evortriede/CurrentMonitor/hardware/CurrentMonitorBOM.md

# Current Monitor Bill of Materials

- Obtained specifically for this project
  - Heltec ESP32 LoRa V2 microcontroller [ESP32](https://smile.amazon.com/gp/product/B07HJ49VN8)
  - High Gain Antenna [Antenna](https://smile.amazon.com/gp/product/B091PRHPTJ)
  - Current Sensor [Sensor](https://smile.amazon.com/gp/product/B00J2N3GSY)
- Various materials on-hand at shop
  - Strip board (cut down to size) [Strip Board](https://smile.amazon.com/gp/product/B088GSJM7G)
  - Wire
  - Resistors
  - Solder
  - Dupont Connector Kit [Dupont kit](https://smile.amazon.com/gp/product/B07JG8HVLG)
    - Dupont Connectors
    - Sockets
    - Headers
