evortriede/CurrentMonitor/(list of files, drawings)

Other design files:
hardware/Current Monitor V4.dsn
