evortriede/CurrentMonitor/ModBussLoop.ino

bool getConnection()
{
  if (!client.connected())
  {
    if (millis()>=timeToConnect)
    {
      Serial.print("connecting to ");
      Serial.println(configData.modbusServer);
      if (client.connect(configData.modbusServer,502))
      {
        timeToSendVolume=millis();
        timeToSendTurbidity=millis()+30000L;
        Serial.println("connected");
      }
      else
      {
        Serial.println("couldn't connect");
        timeToConnect=millis()+60000;
        return false;
      }
      transId=1;
      volTid=0;
      turbTid=0;
    }
  }
  return true;
}

bool getNewConnection()
{
  client.stop();
  return getConnection();
}

uint16_t getUInt16(byte *msg)
{
  uint16_t retVal=msg[0];
  retVal<<=8;
  retVal+=msg[1];
  return retVal;
}

void sendReadHoldingRegister(uint16_t registerNo, uint16_t transactionId)
{
  byte message[12];
  message[0]=transactionId>>8;
  message[1]=transactionId&0xff;
  message[2]=0; // protocol id
  message[3]=0; // protocol id
  message[4]=0; // length msb
  message[5]=6; // length lsb
  message[6]=0; // unit id
  message[7]=3; // function code (read holding registers)
  message[8]=registerNo>>8;
  message[9]=registerNo&0xff;
  message[10]=0; // how many msb
  message[11]=1; // how many lsb
  client.write(message,12);
}

void modbusWriteRegisters(uint16_t startingRegNo, uint16_t *rgVal, byte nVal)
{
  if (!wifiStaConnected) return;

  if (!getConnection()) return;

  byte message[22];
  uint16_t *ps;
  message[0]=transId>>8;
  message[1]=transId&0xff;
  transId+=1;
  if (transId==0) transId=1;
  message[2]=0; // protocol id
  message[3]=0; // protocol id
  message[4]=0; // length lsb
  message[5]=7+(2*nVal); // length msb
  message[6]=0; // unit id
  message[7]=16; // function code (write holding registers)
  message[8]=startingRegNo>>8;
  message[9]=startingRegNo&0xff;
  message[10]=0;
  message[11]=nVal;
  message[12]=nVal*2;
  ps=(uint16_t*)(void*)&message[13];
  for (int j=0;j<nVal;j++)
  {
    *ps++=*rgVal++;
  }
  client.write(message, 13+(2*nVal));
}

bool pollResponse(uint16_t &transactionId, uint16_t &respValue, uint16_t &swapRet)
{
  byte message[12];
  if (client.available()<10) return false;
  Serial.printf("available=%i\n",client.available());
  for (int i=0;client.available();i++)
  {
    message[i]=client.read();
    Serial.printf("%02x ",message[i]);
  }
  Serial.println();
  transactionId=getUInt16(message);
  respValue=getUInt16(&message[9]);
  swapRet=message[10];
  swapRet<<=8;
  swapRet+=message[9];
  Serial.printf("transId=%u Val=%i Swap=%04x\n",transactionId,respValue,swapRet);
  return true;
}

void sendVal(byte tag, uint16_t val)
{
  uint16_t *ps;
  byte msg[3];
  msg[0]=tag;
  ps=(uint16_t*)&msg[1];
  *ps=val;
  report((void*)msg,3);
}

uint16_t swapBytes(uint16_t val)
{
  uint16_t retVal=val&0xff;
  retVal<<=8;
  retVal+=((val>>8)&0xff);
  return retVal;
}

void modbusLoop() 
{
  uint16_t tid,val,swapVal;
  
  if (!wifiStaConnected) return;

  if (!getConnection()) return;

  if (pollResponse(tid,val,swapVal))
  {
    Serial.printf("%i %i %04x\n",tid,val,swapVal);
    if (tid && tid==turbTid)
    {
      turbTid=0;
      if (val!=0)
      {
        sendVal('T',val);
      }
      turbidity = val;
    }
    else if (tid && tid==volTid)
    {
      volTid=0;
      sendVal('r',val);
      gallons = (698 * val) / 100;
    }
  }

  if (millis()>timeToSendVolume)
  {
    if (volTid!=0)
    {
      if (!getNewConnection()) return;
    }
    timeToSendVolume=millis()+(1000*configData.frequency);
    volTid=transId++;
    if (transId==0) transId=1; // 1-FFFF never 0
    sendReadHoldingRegister(0x8b,volTid);
  }

  if (millis()>timeToSendTurbidity)
  {
    if (turbTid!=0)
    {
      if (!getNewConnection()) return;
    }
    timeToSendTurbidity=millis()+(1000*configData.frequency);
    turbTid=transId++;
    if (transId==0) transId=1; // 1-FFFF never 0
    sendReadHoldingRegister(0x64,turbTid);
  }
}
