evortriede/CurrentMonitor/(commit log)

2023-02-10 Documentation and mDNS
    [Current Monitor V4.dsn]
2023-06-06 Read data from CurrentMonitor
    Now makes a TCP connection to CurrentMonitor over port 9023 over which it receives metrics and records them.
2024-07-20 Update ModBussLoop.ino
    Reset TID values when new connection is established.
    Set turbidity value even when it goes to zero.
    [ModBussLoop.ino]
2025-09-24 New Heltec and ESP32 libs
